niklasekstrom/clockport_pi_interface/Docs/compact_pcb.png

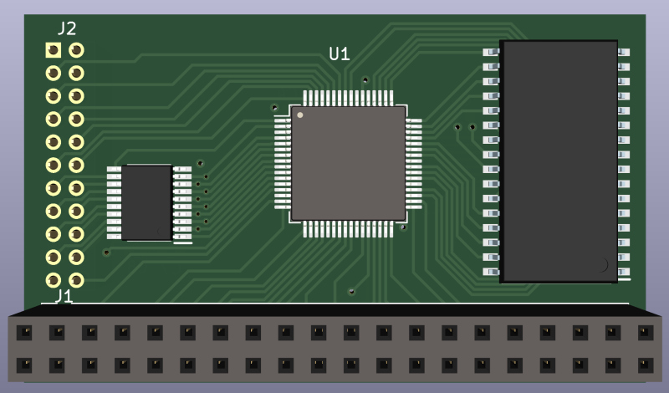
Docs/compact_pcb.png
