niklasekstrom/clockport_pi_interface/Docs/fit_shield_pcb.png

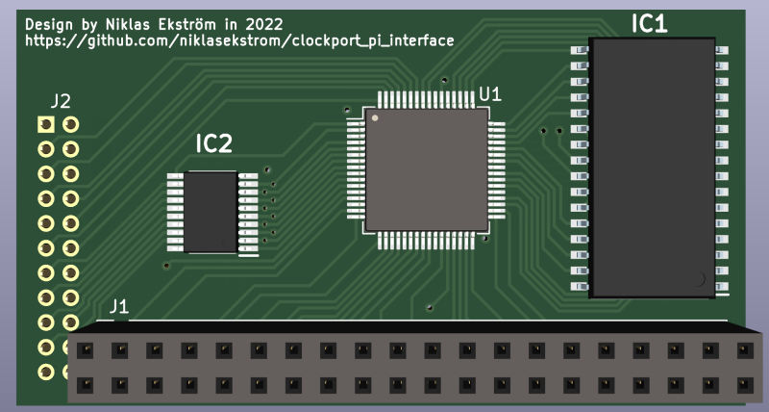
Docs/fit_shield_pcb.png
