niklasekstrom/clockport_pi_interface/Docs/installed_pi_3a.jpg

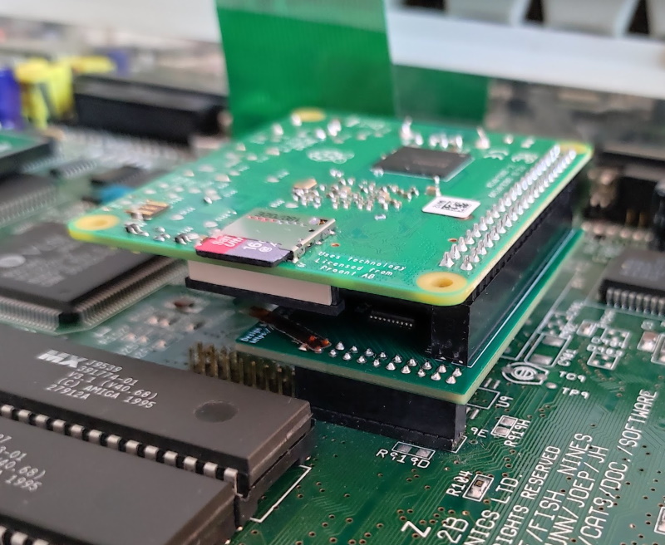
Docs/installed_pi_3a.jpg
