niklasekstrom/clockport_pi_interface/(commit log)

2022-06-15 Fixed typo
    [cp_pi_if.kicad_sch, cp_pi_if_compact.kicad_pcb, cp_pi_if_fit_shield.kicad_pcb]
2022-06-16 Added missing ground via
    [cp_pi_if.kicad_sch, cp_pi_if_compact.kicad_pcb, cp_pi_if_fit_shield.kicad_pcb]
2022-06-17 Add silkscreen text to fit_shield PCB
    The fit_shield variant of the PCB is supposed to fit into the opening
    of the A1200 RF shield.
    [cp_pi_if_fit_shield.kicad_pcb]
2022-06-18 Fixes that LE_OUT is active high
    [cp_pi_if.ucf]
2022-06-18 Use SPARE_CS instead of RTC_CS
    [cp_pi_if.kicad_sch, cp_pi_if_compact.kicad_pcb, cp_pi_if_fit_shield.kicad_pcb]
2022-07-25 Add bill of materials
2022-09-17 Add alternative parts for IC1, IC2 and IC3 in BOM
